ledroneclub/pickle-ng_frame/README.md

# pickle-ng

You'll find here the latest version of the Pickle frame as of September 2019. Those 2 frames have been reworked for simplicity, and durability.

Check in the "releases" menu for the latest good versions.

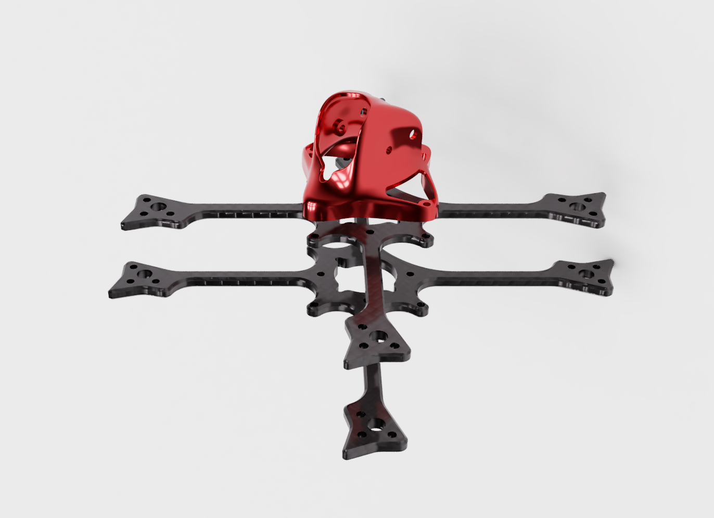
[picture p1: gfx/render2.png]
Pickle Evo2 MK2


You may follow me on [Instagram](https://www.instagram.com/ledrone.club/) and [YouTube](https://www.youtube.com/c/ledroneclub/)

Pickle-ng frames come in 2 versions :

## 65mm trueX version

* 102mm wheelbase
* Fits 9mm motors with 4 holes mount (like 110x, 120x, etc.)
* Whoop AIO (26x26mm) and 16x16 FC mount
* recommended CNC cutting : 2.5mm thick with chamfer
* estimated weight : ~5.4g

## 3inch trueX version 

* 116mm wheelbase
* Fits 9mm motors with 4 holes mount (like 110x, 120x, 130x, etc.)
* Whoop AIO (26x26mm) and 16x16 FC mount
* recommended CNC cutting : 3mm thick with chamfer (along weave)
* estimated weight : ~7g

**The 3HOLE version of each frame will fit 3 hole motors as the Amaxinno 1103, Happymodel 1102/3**

## 4inch trueX version

yes, theres even a 4 inch version
* 153mm wheelbase
* fits 9mm motors with 4 holes mount (think 130x, 140x)
* Whoop AIO (26x26mm), 16x16mm and 20x20mm FC mount
* USB cutout (to put back the 4th screw for the whoop aio mount)
* Estimated weight 12-15g
* 6mm and 7mm wide arms versions

## How to get this frame ?

You have to make it cut at a CNC Cutting service, here's some recommended ones.

* https://www.cncmadness.com (US/CA)
* https://www.ahltec.de (EU)

Get the files in the ```dxf_for_cnc_cutting``` folder (dxf files) and send them to the services mentionned above.

TODO : Testing required
