ledroneclub/pickle-ng_frame/gfx/render1.png

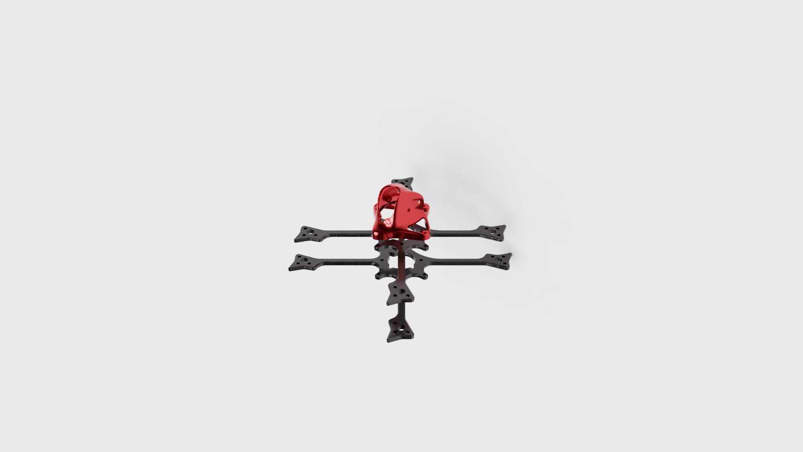
gfx/render1.png
