ledroneclub/pickle-ng_frame/dxf_for_cnc_cutting/PicklePick2_trueX_2in_87mm_3HOLE_v1-0.dxf

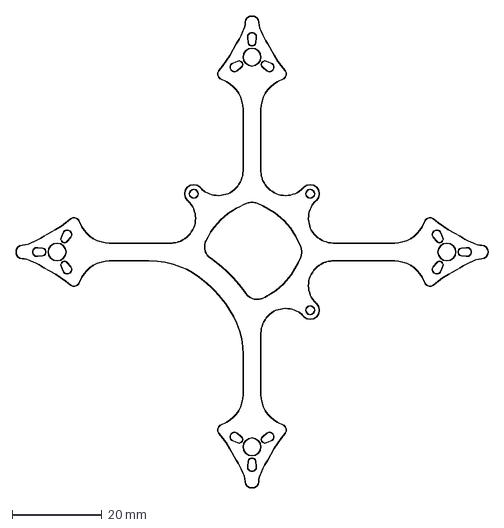
[picture p3: CAD file, 2019-12-12]
dxf_for_cnc_cutting/PicklePick2_trueX_2in_87mm_3HOLE_v1-0.dxf
105.4 x 105.4 mm
