ledroneclub/pickle-ng_frame/frame_accessories/runcam_vtx mount_v1.stl

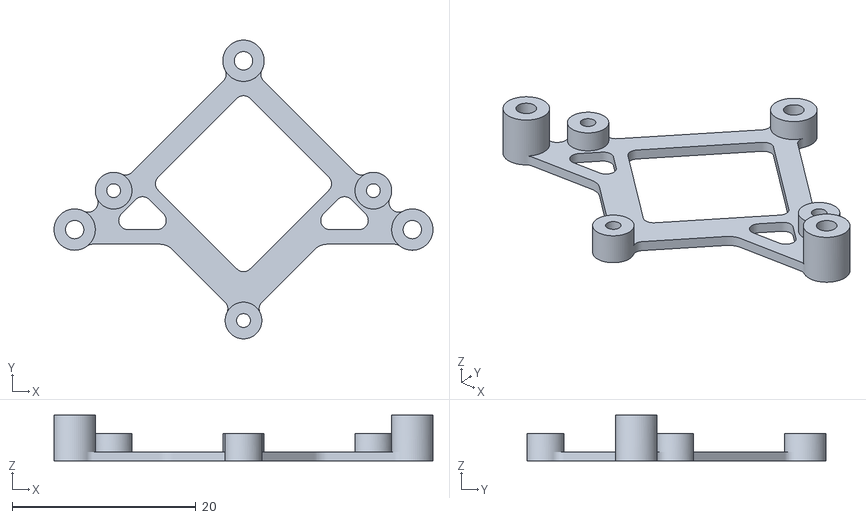
[picture p4: CAD file, 2019-09-03]
frame_accessories/runcam_vtx mount_v1.stl
41.3 x 32.5 x 5.00
