ledroneclub/pickle-ng_frame/PickleBig5_trueX_SHORT_5in_190mm_4Hvariant_v1-0.stl

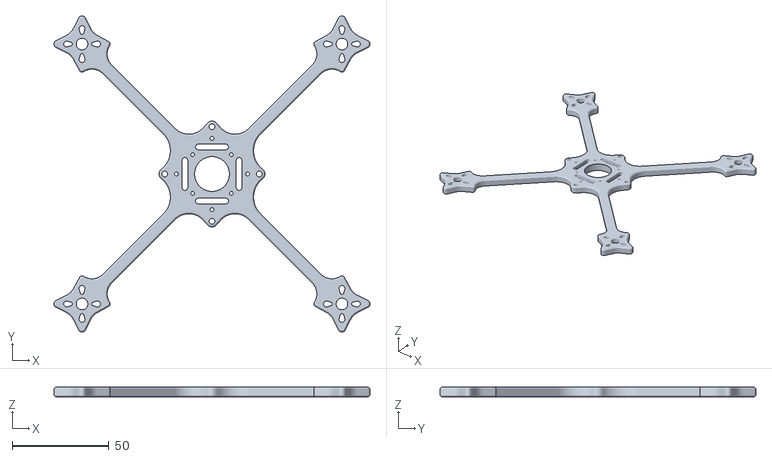
[picture p5: CAD file, 2019-11-14]
PickleBig5_trueX_SHORT_5in_190mm_4Hvariant_v1-0.stl
163.3 x 163.3 x 5.00
