ledroneclub/pickle-ng_frame/dxf_for_cnc_cutting/PickleBig5_trueX_SHORT_5in_190mm_4Hvariant_v1-0.dxf

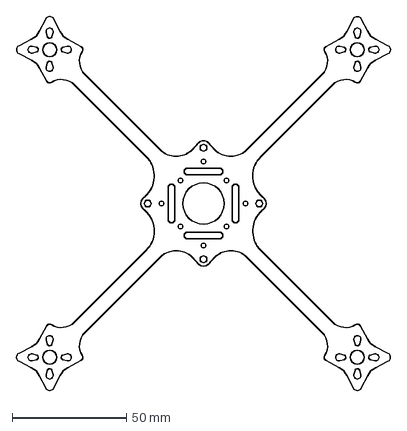
[picture p6: CAD file, 2019-11-14]
dxf_for_cnc_cutting/PickleBig5_trueX_SHORT_5in_190mm_4Hvariant_v1-0.dxf
163.4 x 163.4 mm
