ledroneclub/pickle-ng_frame/frame_accessories/pickle_XF_race_holder.stl

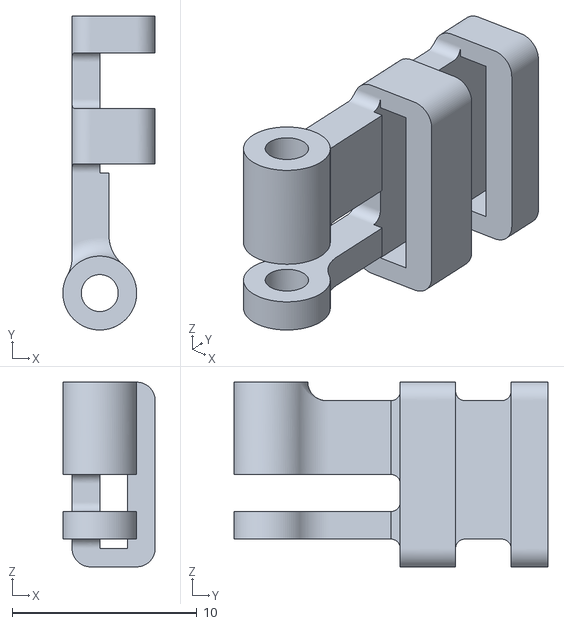
[picture p7: CAD file, 2019-09-03]
frame_accessories/pickle_XF_race_holder.stl
5.00 x 17.0 x 10.0
