ledroneclub/pickle-ng_frame/PickleBig4_trueX_4in_153mm_6mm-arm_v1-3.stl

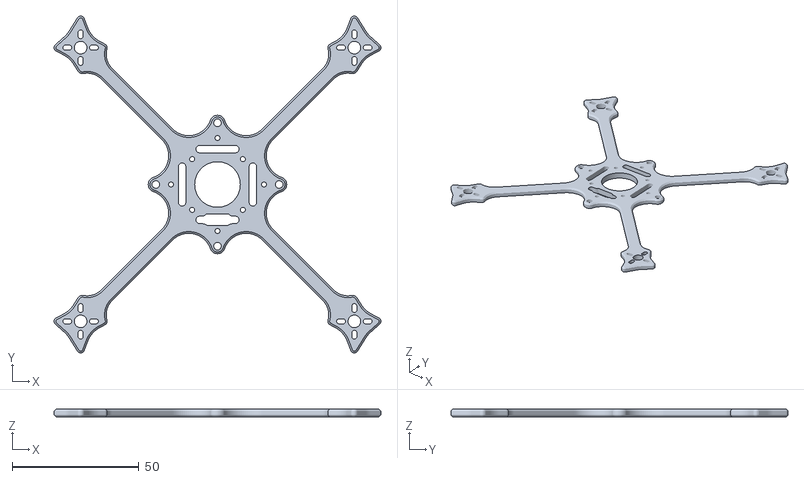
[picture p8: CAD file, 2019-11-11]
PickleBig4_trueX_4in_153mm_6mm-arm_v1-3.stl
129.2 x 133.2 x 3.00
