ledroneclub/pickle-ng_frame/dxf_for_cnc_cutting/PickleBig4_trueX_4in_153mm_6mm-arm_v1-3.dxf

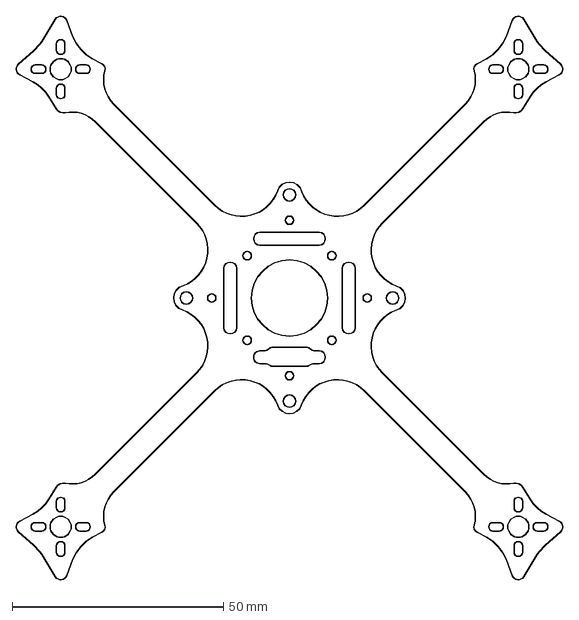
[picture p9: CAD file, 2019-11-11]
dxf_for_cnc_cutting/PickleBig4_trueX_4in_153mm_6mm-arm_v1-3.dxf
129.3 x 133.3 mm
