ledroneclub/pickle-ng_frame/frame_accessories/pickle_batt_holder_2S_transversal.stl

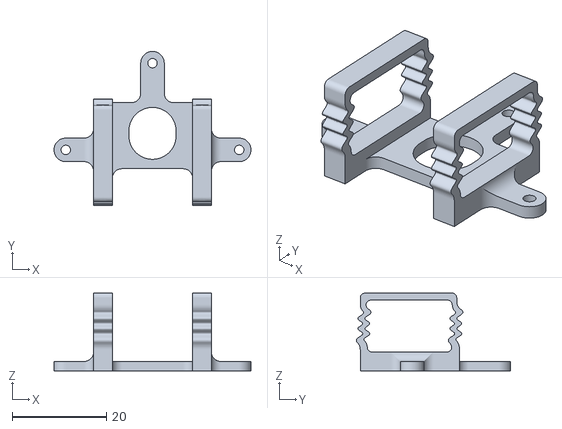
[picture p10: CAD file, 2019-09-03]
frame_accessories/pickle_batt_holder_2S_transversal.stl
41.8 x 32.7 x 16.5
