ledroneclub/pickle-ng_frame/dxf_for_cnc_cutting/PickleBig5_trueX_SHORT_5in_190mm_v1-0.dxf

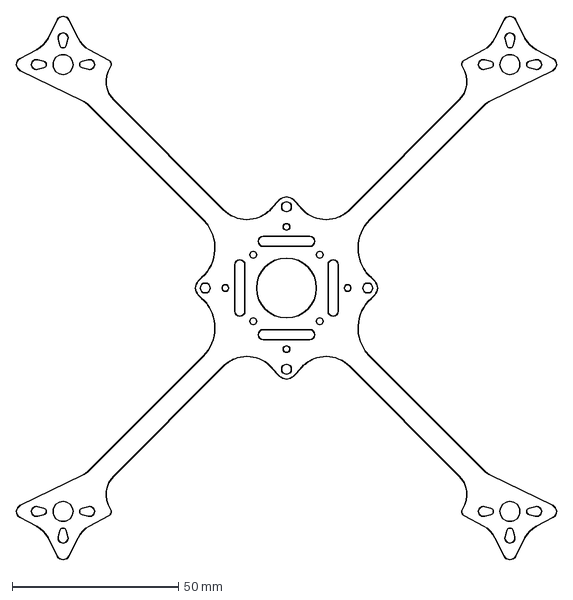
[picture p11: CAD file, 2019-11-05]
dxf_for_cnc_cutting/PickleBig5_trueX_SHORT_5in_190mm_v1-0.dxf
162.4 x 163.4 mm
