ledroneclub/pickle-ng_frame/PickleBig5_trueX_5in_200mm_7mm-arm_v1-5.stl

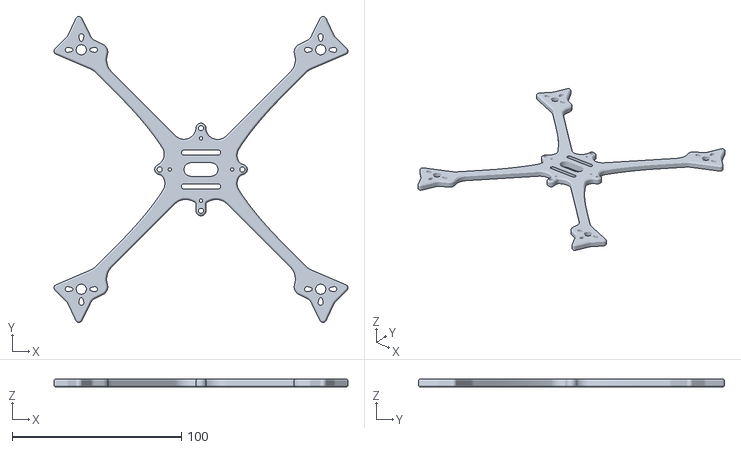
[picture p12: CAD file, 2019-10-28]
PickleBig5_trueX_5in_200mm_7mm-arm_v1-5.stl
173.7 x 180.8 x 5.00
