ledroneclub/pickle-ng_frame/dxf_for_cnc_cutting/PickleBig5_trueX_5in_200mm_7mm-arm_v1-5.dxf

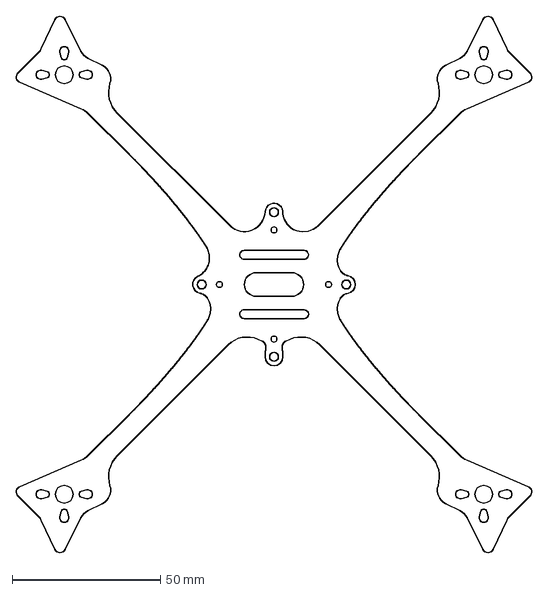
[picture p13: CAD file, 2019-10-28]
dxf_for_cnc_cutting/PickleBig5_trueX_5in_200mm_7mm-arm_v1-5.dxf
173.9 x 180.8 mm
