ledroneclub/pickle-ng_frame/frame_accessories/pickle_batt_holder_3S_transversal.stl

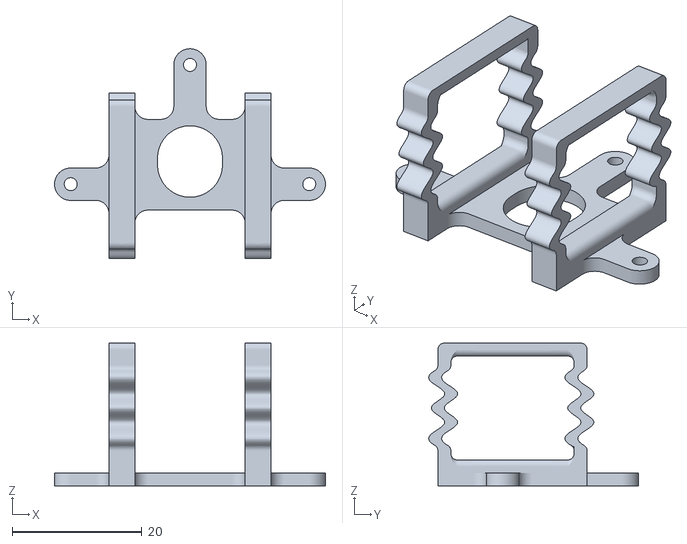
[picture p14: CAD file, 2019-09-03]
frame_accessories/pickle_batt_holder_3S_transversal.stl
41.8 x 32.3 x 22.0
