ledroneclub/pickle-ng_frame/PicklePick3_trueX_3in_125mm_v1-0.stl

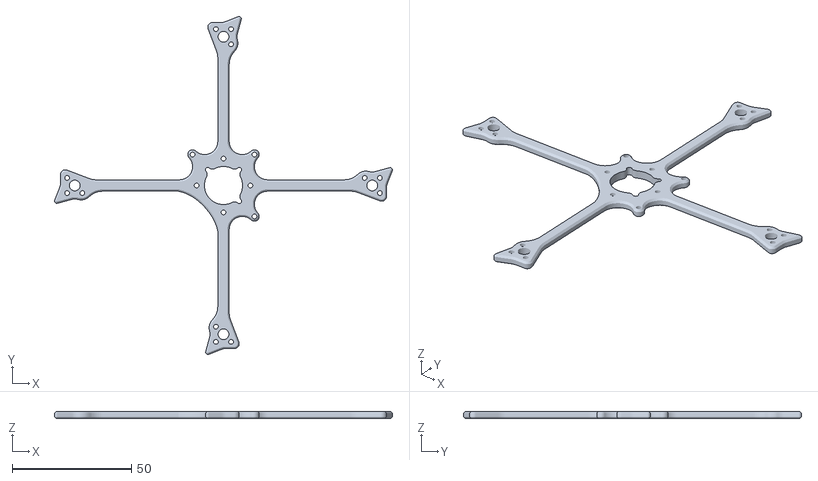
[picture p15: CAD file, 2019-10-03]
PicklePick3_trueX_3in_125mm_v1-0.stl
142.0 x 142.0 x 3.00
