ledroneclub/pickle-ng_frame/PicklePick3_trueX_3in_116mm_v1-2.stl

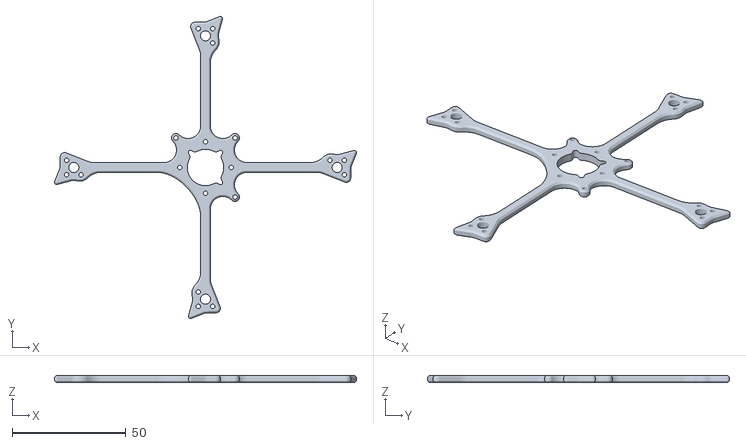
[picture p16: CAD file, 2019-10-01]
PicklePick3_trueX_3in_116mm_v1-2.stl
133.0 x 133.0 x 3.00
