ledroneclub/pickle-ng_frame/dxf_for_cnc_cutting/PicklePick3_trueX_3in_125mm_v1-0.dxf

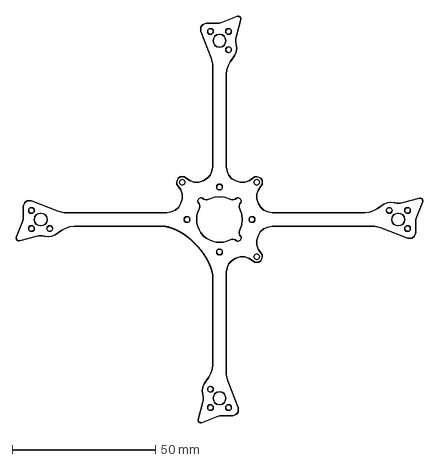
[picture p17: CAD file, 2019-10-03]
dxf_for_cnc_cutting/PicklePick3_trueX_3in_125mm_v1-0.dxf
142.1 x 142.1 mm
