ledroneclub/pickle-ng_frame/PickleBig4_trueX_4in_153mm_7mm-arm_v1-1.stl

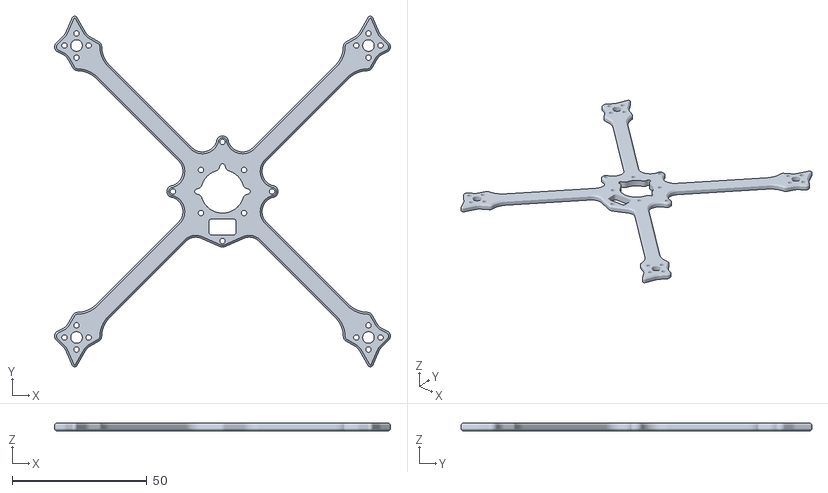
[picture p18: CAD file, 2019-09-20]
PickleBig4_trueX_4in_153mm_7mm-arm_v1-1.stl
124.5 x 130.0 x 3.00
