ledroneclub/pickle-ng_frame/dxf_for_cnc_cutting/PicklePick3_trueX_3in_116mm_v1-2.dxf

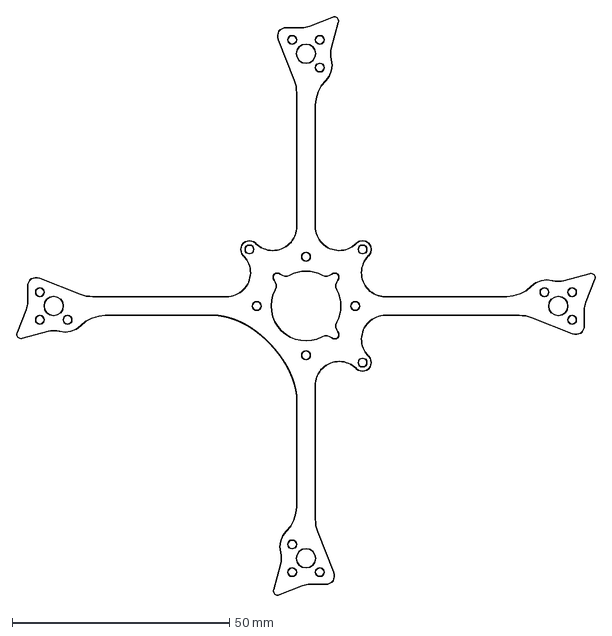
[picture p19: CAD file, 2019-10-01]
dxf_for_cnc_cutting/PicklePick3_trueX_3in_116mm_v1-2.dxf
133.1 x 133.1 mm
