ledroneclub/pickle-ng_frame/PicklePick3_trueX_3in_116mm_3HOLE_v1-1.stl

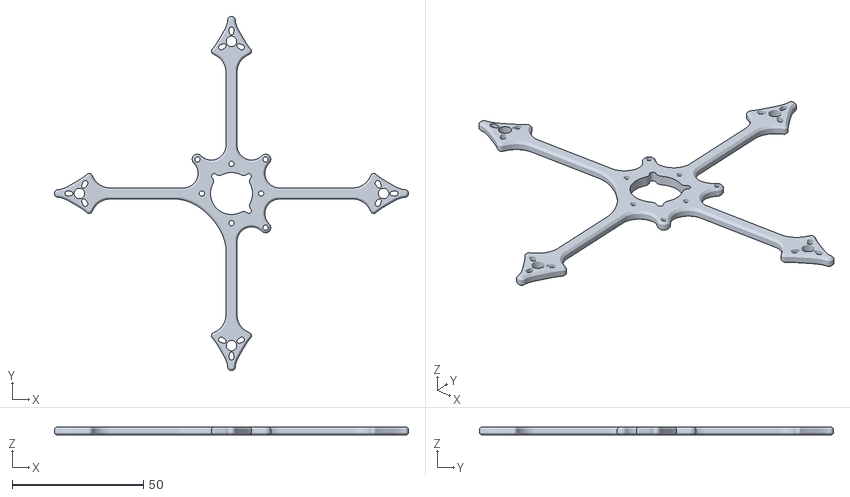
[picture p20: CAD file, 2019-09-19]
PicklePick3_trueX_3in_116mm_3HOLE_v1-1.stl
135.0 x 135.0 x 3.00
