ledroneclub/pickle-ng_frame/dxf_for_cnc_cutting/PickleBig4_trueX_4in_153mm_7mm-arm_v1-1.dxf

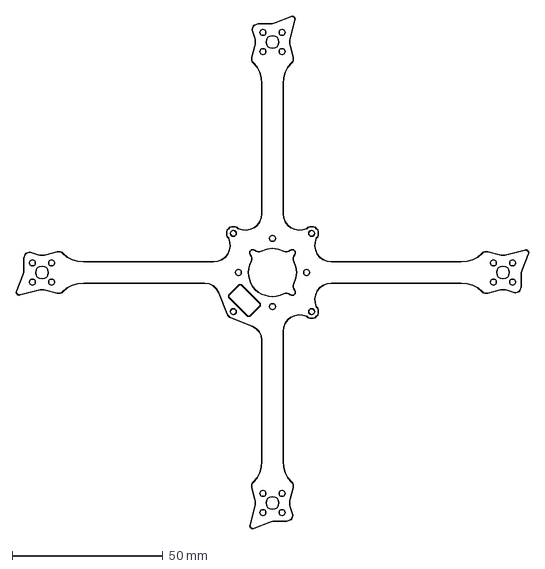
[picture p21: CAD file, 2019-09-20]
dxf_for_cnc_cutting/PickleBig4_trueX_4in_153mm_7mm-arm_v1-1.dxf
170.1 x 170.1 mm
