ledroneclub/pickle-ng_frame/PicklePick65_trueX_65mm_102mm_3HOLE_v1-0.stl

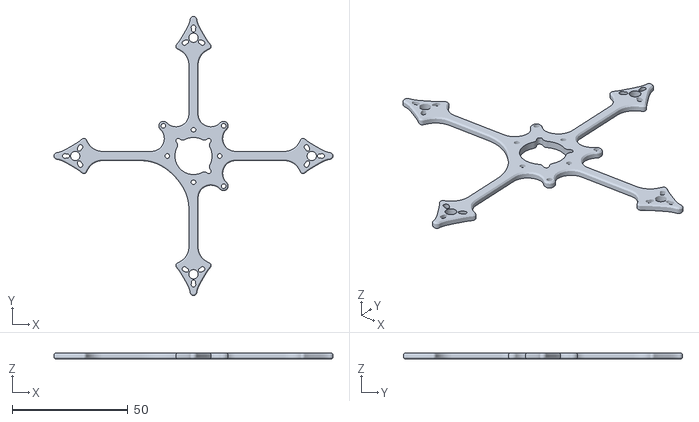
[picture p22: CAD file, 2019-09-19]
PicklePick65_trueX_65mm_102mm_3HOLE_v1-0.stl
120.4 x 120.4 x 2.50
