ledroneclub/pickle-ng_frame/dxf_for_cnc_cutting/PicklePick3_trueX_3in_116mm_3HOLE_v1-1.dxf

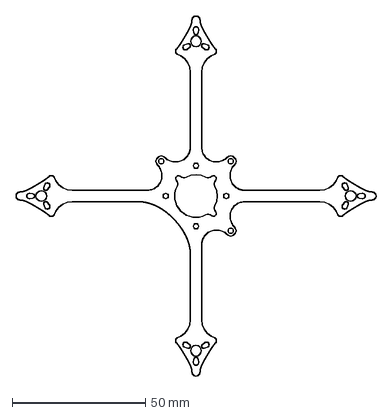
[picture p23: CAD file, 2019-09-19]
dxf_for_cnc_cutting/PicklePick3_trueX_3in_116mm_3HOLE_v1-1.dxf
135.0 x 135.0 mm
