ledroneclub/pickle-ng_frame/PicklePick65_trueX_65mm_102mm_v1-0.stl

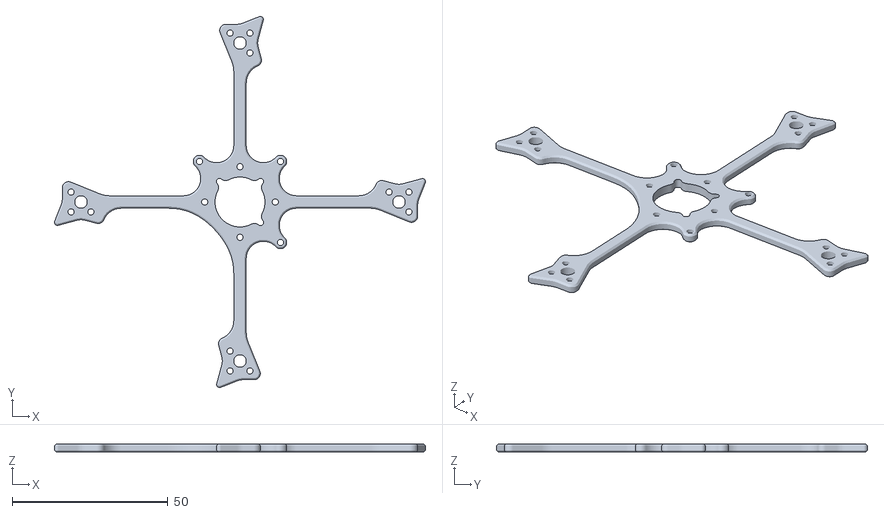
[picture p24: CAD file, 2019-09-02]
PicklePick65_trueX_65mm_102mm_v1-0.stl
119.0 x 119.0 x 2.50
