ledroneclub/pickle-ng_frame/dxf_for_cnc_cutting/PicklePick65_trueX_65mm_102mm_3HOLE_v1-0.dxf

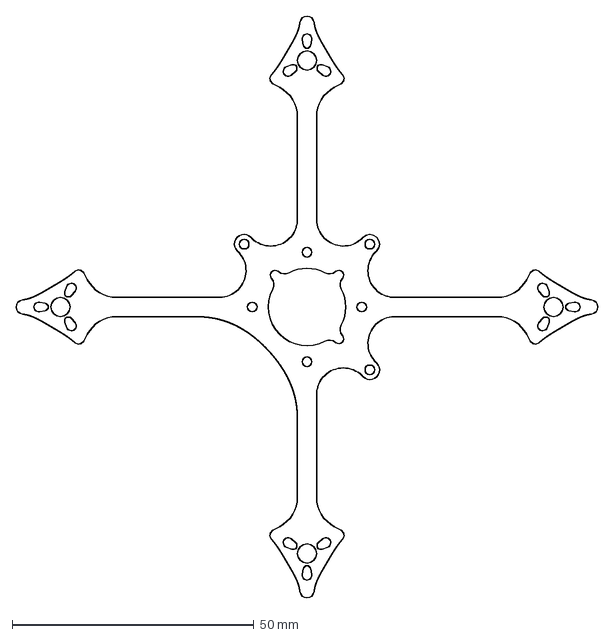
[picture p25: CAD file, 2019-09-19]
dxf_for_cnc_cutting/PicklePick65_trueX_65mm_102mm_3HOLE_v1-0.dxf
120.4 x 120.4 mm
