ledroneclub/pickle-ng_frame/dxf_for_cnc_cutting/pickleNG_trueX_4inch_153mm_v1-0.dxf

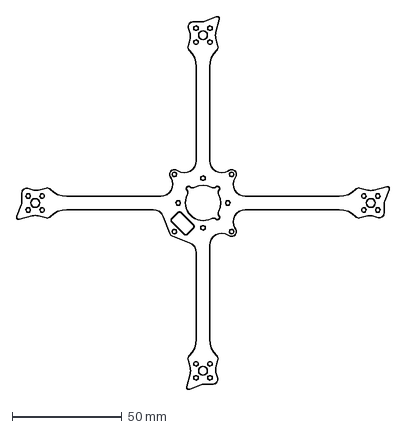
[picture p26: CAD file, 2019-09-06]
dxf_for_cnc_cutting/pickleNG_trueX_4inch_153mm_v1-0.dxf
170.1 x 170.1 mm
