ledroneclub/pickle-ng_frame/dxf_for_cnc_cutting/PicklePick65_trueX_65mm_102mm_v1-0.dxf

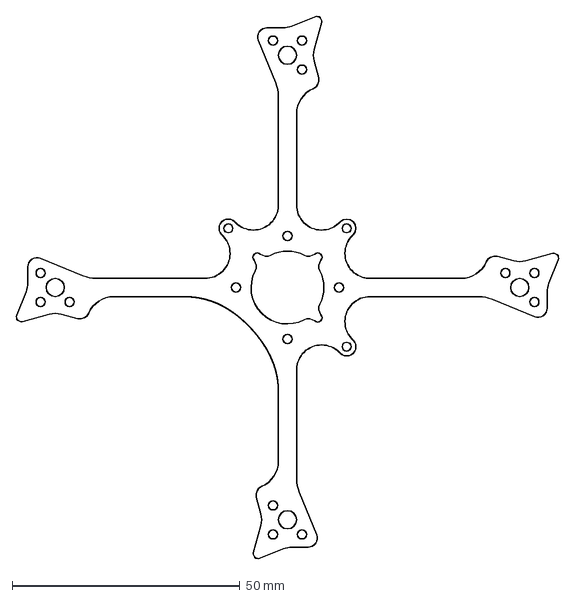
[picture p27: CAD file, 2019-09-02]
dxf_for_cnc_cutting/PicklePick65_trueX_65mm_102mm_v1-0.dxf
119.1 x 119.1 mm
