ledroneclub/pickle-ng_frame/(list of files, cad)

Other CAD files:
PickleBig5_trueX_SHORT_5in_190mm_v1-0.stl
frame_accessories/m2_3mm_spacer.stl
frame_accessories/m2_4mm_spacer.stl
