ledroneclub/pickle-ng_frame/(commit log)

2019-09-02 initial file add
    [pickleNG_trueX_3inch_112mm_v1-0.dxf, pickleNG_trueX_3inch_112mm_v1-0.stl, pickleNG_trueX_65mm_102mm_v1-0.dxf, pickleNG_trueX_65mm_102mm_v1-0.stl]
2019-09-02 corrected size error on the 3 inch frame
    [pickleNG_trueX_3inch_112mm_v1-0.dxf, pickleNG_trueX_3inch_112mm_v1-0.stl]
2019-09-03 added some frame accessories
    [m2_3mm_spacer.stl, m2_4mm_spacer.stl, pickle_XF_race_holder.stl, pickle_batt_holder_2S_transversal.stl, pickle_batt_holder_3S_transversal.stl, runcam_vtx mount_v1.stl]
2019-09-06 added a 4 inch version
    [pickleNG_trueX_4inch_153mm_v1-0.dxf, pickleNG_trueX_4inch_153mm_v1-0.stl]
2019-09-06 added a 7mm wide arms variant for 4 inch frame
    [pickleNG_trueX_4inch_153mm_7mm-arms_v1-0.dxf, pickleNG_trueX_4inch_153mm_7mm-arms_v1-0.stl]
2019-09-19 added 3 hole motor versions for the 65mm and 3 inch, on popular demand. Those will fit Amax 1103 motors and happymodel with 6.6mm mount
    [pickleNG_trueX_3inch_112mm_3HOLE_v1-0.dxf, pickleNG_trueX_3inch_112mm_3HOLE_v1-0.stl, pickleNG_trueX_65mm_102mm_3HOLE_v1-0.dxf, pickleNG_trueX_65mm_102mm_3HOLE_v1-0.stl]
2019-09-19 updated 3 inch 3 holes frame : wheelbase to 116mm
    [pickleNG_trueX_3inch_112mm_3HOLE_v1-0.dxf, pickleNG_trueX_3inch_112mm_3HOLE_v1-0.stl, pickleNG_trueX_3inch_116mm_3HOLE_v1-1.dxf, pickleNG_trueX_3inch_116mm_3HOLE_v1-1.stl]
2019-09-19 new wheelbase is 116mm for 3 inch version
    [pickleNG_trueX_3inch_112mm_v1-0.dxf, pickleNG_trueX_3inch_112mm_v1-0.stl, pickleNG_trueX_3inch_116mm_v1-1.dxf, pickleNG_trueX_3inch_116mm_v1-1.stl]
2019-09-19 republished 3 inch frame
    [pickleNG_trueX_3inch_116mm_3HOLE_v1-1.dxf, pickleNG_trueX_3inch_116mm_3HOLE_v1-1.stl, pickleNG_trueX_3inch_116mm_v1-1.dxf, pickleNG_trueX_3inch_116mm_v1-1.stl]
2019-09-20 widened the motor hole from 4mm to 4.3mm
    [pickleNG_trueX_4inch_153mm_6mm-arm_v1-1.dxf, pickleNG_trueX_4inch_153mm_6mm-arm_v1-1.stl, pickleNG_trueX_4inch_153mm_7mm-arm_v1-1.dxf, pickleNG_trueX_4inch_153mm_7mm-arm_v1-1.stl, pickleNG_trueX_4inch_153mm_7mm-arms_v1-0.dxf, pickleNG_trueX_4inch_153mm_7mm-arms_v1-0.stl, pickleNG_trueX_4inch_153mm_v1-0.stl]
2019-09-23 bigger central motor hole for 3 inch / 4 hole frame version
    [pickleNG_trueX_3inch_116mm_v1-1.dxf, pickleNG_trueX_3inch_116mm_v1-1.stl]
2019-10-01 motor shaft hole to 4.6mm on 3 inch 4 hole frame
    [pickleNG_trueX_3inch_116mm_v1-1.dxf, pickleNG_trueX_3inch_116mm_v1-1.stl, pickleNG_trueX_3inch_116mm_v1-2.dxf, pickleNG_trueX_3inch_116mm_v1-2.stl]
2019-10-01 motor hole set to 4.45mm
    [pickleNG_trueX_3inch_116mm_v1-2.dxf, pickleNG_trueX_3inch_116mm_v1-2.stl]
2019-10-03 added a 125mm wheelbase 3 inch version (4hole)
    [pickleNG_trueX_3inch_125mm_v1-0.dxf, pickleNG_trueX_3inch_125mm_v1-0.stl]
2019-10-11 added a first 5 inch version
    [pickleNG_trueX_5inch_200mm_7mm-arm_v1-0.dxf, pickleNG_trueX_5inch_200mm_7mm-arm_v1-0.stl]
2019-10-13 added strap cuts for the 5inch Pickle monster
    [pickleNG_trueX_5inch_200mm_7mm-arm_v1-0.dxf, pickleNG_trueX_5inch_200mm_7mm-arm_v1-0.stl, pickleNG_trueX_5inch_200mm_7mm-arm_v1-1.dxf, pickleNG_trueX_5inch_200mm_7mm-arm_v1-1.stl]
2019-10-16 added 20x20 mount on 5 inch frame
    [pickleNG_trueX_5inch_200mm_7mm-arm_v1-1.dxf, pickleNG_trueX_5inch_200mm_7mm-arm_v1-1.stl, pickleNG_trueX_5inch_200mm_7mm-arm_v1-3.dxf, pickleNG_trueX_5inch_200mm_7mm-arm_v1-3.stl]
2019-10-20 added mounts for canopy on the 5 inch frame
    [pickleNG_trueX_5inch_200mm_7mm-arm_v1-3.dxf, pickleNG_trueX_5inch_200mm_7mm-arm_v1-3.stl, pickleNG_trueX_5inch_200mm_7mm-arm_v1-4.dxf, pickleNG_trueX_5inch_200mm_7mm-arm_v1-4.stl]
2019-10-21 slight arm modification on the 5 inch
    [pickleNG_trueX_5inch_200mm_7mm-arm_v1-4.dxf, pickleNG_trueX_5inch_200mm_7mm-arm_v1-4.stl]
2019-10-27 some corrections & design simplificationson the 5 inch frame
    [pickleNG_trueX_5inch_200mm_7mm-arm_v1-4.stl, pickleNG_trueX_5inch_200mm_7mm-arm_v1-5.dxf, pickleNG_trueX_5inch_200mm_7mm-arm_v1-5.stl]
2019-10-27 modified the 4 inch to have a 9-12mm motor mount and bigger motor central hole to fit bigger motors
    [pickleNG_trueX_4inch_153mm_6mm-arm_v1-1.dxf, pickleNG_trueX_4inch_153mm_6mm-arm_v1-1.stl, pickleNG_trueX_4inch_153mm_6mm-arm_v1-2.dxf, pickleNG_trueX_4inch_153mm_6mm-arm_v1-2.stl]
2019-10-27 4 inch : 9-12mm motor mount, 5mm hub hole and canopy mount separated from stack screws
    [pickleNG_trueX_4inch_153mm_6mm-arm_v1-2.dxf, pickleNG_trueX_4inch_153mm_6mm-arm_v1-2.stl]
2019-10-27 added a canopy for the PickleBig frames (4 and 5 inch)
2019-10-28 5 inch, slight modification of the battery slots. the spacing is 20mm so can be used for a 20x20 stack
    [pickleNG_trueX_5inch_200mm_7mm-arm_v1-5.dxf, pickleNG_trueX_5inch_200mm_7mm-arm_v1-5.stl]
2019-11-04 repo cleanup
    [pickleNG_trueX_3inch_116mm_3HOLE_v1-1.dxf, pickleNG_trueX_3inch_116mm_3HOLE_v1-1.stl, pickleNG_trueX_3inch_116mm_v1-2.dxf, pickleNG_trueX_3inch_116mm_v1-2.stl, pickleNG_trueX_3inch_125mm_v1-0.dxf, pickleNG_trueX_3inch_125mm_v1-0.stl, pickleNG_trueX_4inch_153mm_6mm-arm_v1-2.dxf, pickleNG_trueX_4inch_153mm_6mm-arm_v1-2.stl]
2019-11-04 Renamed all files, Added a short version of the PickleBig 5in with 190mm wheelbase
    [PickleBig4_trueX_4in_153mm_6mm-arm_v1-2.dxf, PickleBig4_trueX_4in_153mm_6mm-arm_v1-2.stl, PickleBig4_trueX_4in_153mm_7mm-arm_v1-1.dxf, PickleBig4_trueX_4in_153mm_7mm-arm_v1-1.stl, PickleBig5_trueX_5in_200mm_7mm-arm_v1-5.dxf, PickleBig5_trueX_5in_200mm_7mm-arm_v1-5.stl, PickleBig5_trueX_SHORT_5in_190mm_7mm-arm_v1-0.dxf, PickleBig5_trueX_SHORT_5in_190mm_7mm-arm_v1-5.stl]
2019-11-05 new version of the 5mm short
    [PickleBig5_trueX_SHORT_5in_190mm_7mm-arm_v1-0.dxf, PickleBig5_trueX_SHORT_5in_190mm_7mm-arm_v1-5.stl]
2019-11-05 new 5in short
    [PickleBig5_trueX_SHORT_5in_190mm_v1-0.dxf, PickleBig5_trueX_SHORT_5in_190mm_v1-0.stl]
2019-11-11 updated 4inch design
    [PickleBig4_trueX_4in_153mm_6mm-arm_v1-2.dxf, PickleBig4_trueX_4in_153mm_6mm-arm_v1-2.stl, PickleBig4_trueX_4in_153mm_6mm-arm_v1-3.dxf, PickleBig4_trueX_4in_153mm_6mm-arm_v1-3.stl]
2019-11-14 added a PB5 variant with 4 motor holes
    [PickleBig5_trueX_SHORT_5in_190mm_4Hvariant_v1-0.dxf, PickleBig5_trueX_SHORT_5in_190mm_4Hvariant_v1-0.stl]
2019-12-12 added a new 2inch 87mm wheelbase frame for mini extralight setups. 3 hole only for now
    [PicklePick2_trueX_2in_87mm_3HOLE_v1-0.dxf]
