ledroneclub/pickle-ng_frame/dxf_for_cnc_cutting/pickleNG_trueX_5inch_200mm_7mm-arm_v1-4.dxf

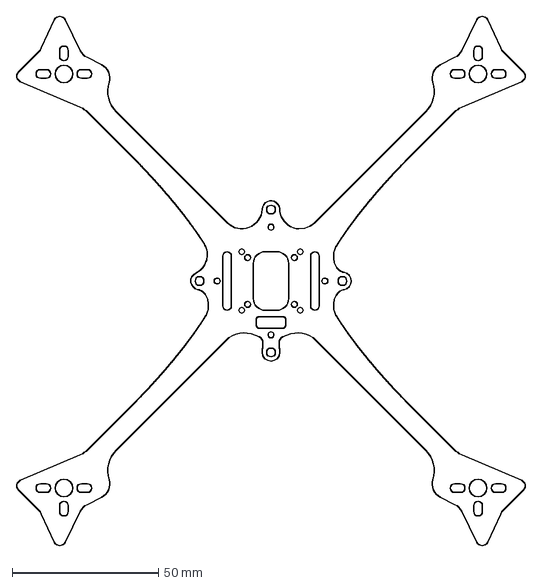
[picture p1: CAD file, 2019-10-21]
dxf_for_cnc_cutting/pickleNG_trueX_5inch_200mm_7mm-arm_v1-4.dxf
173.9 x 180.8 mm
